chancehowarth33/OpenBand/software/firmware/README.md

# Empty application template

This is a minimal starter application template for Infineon MCU devices.

For instructions on modifying and using this application template to create applications, follow steps from the "My first PSoC&trade; 6 MCU design using ModusToolbox&trade;" section in [AN228571](https://www.infineon.com/an228571) – Getting started with PSoC&trade; 6 MCU on ModusToolbox&trade; software, the "My first TRAVEO&trade; T2G family  MCU design using Eclipse IDE for ModusToolbox&trade;" section in [AN235305](https://www.infineon.com/assets/row/public/documents/10/42/infineon-an235305-getting-started-with-traveo-t2g-family-mcus-in-modustoolbox-applicationnotes-en.pdf) – Getting started with TRAVEO&trade; T2G family MCUs in ModusToolbox&trade; software or the "My first XMC7000 MCU design using Eclipse IDE for ModusToolbox&trade;" section in [AN234334](https://www.infineon.com/dgdl/Infineon-AN234334_Getting_started_with_XMC7000_MCU_on_ModusToolbox_software-ApplicationNotes-v01_00-EN.pdf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) – Getting started with XMC7000 MCU on ModusToolbox&trade; software.

[View this README on GitHub.](https://github.com/Infineon/mtb-example-empty-app)

[Provide feedback on this code example.](https://yourvoice.infineon.com/jfe/form/SV_1NTns53sK2yiljn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)

## Requirements

- [ModusToolbox&trade;](https://www.infineon.com/modustoolbox) v3.7 or later (tested with v3.7)
- Board support package (BSP) minimum required version for :
   - PSoC&trade; 6 MCU: v4.0.0
   - KIT_XMC72_EVK: v1.0.0
   - CYW920829M2EVK-02: v1.0.1
   - CYW989829M2EVB-01: v1.0.1
   - KIT_XMC52_EVK: v3.0.0
   - KIT_T2G-B-H_EVK: v3.0.0
   - KIT_T2G-B-H_LITE: v3.0.0
   - KIT_T2G_C-2D-6M_EVK: v3.0.0
   - KIT_T2G_C-2D-4M_EVK: v3.0.0
- Programming language: C
- Associated parts: All [PSoC&trade; 6 MCU](https://www.infineon.com/cms/en/product/microcontroller/32-bit-psoc-arm-cortex-microcontroller/psoc-6-32-bit-arm-cortex-m4-mcu) parts, [XMC7000 MCU](https://www.infineon.com/products/microcontroller/32bit-industrial-arm-cortex-m/xmc7000-m7), [XMC5000 MCU](https://www.infineon.com/products/microcontroller/32bit-industrial-arm-cortex-m/xmc5000), [TRAVEO&trade; T2G family Cluster series](https://www.infineon.com/cms/en/product/microcontroller/32-bit-traveo-t2g-arm-cortex-microcontroller/32-bit-traveo-t2g-arm-cortex-for-cluster/), [TRAVEO&trade; T2G family body high CYT4BF series](https://www.infineon.com/products/microcontroller/32-bit-traveo-t2g-arm-cortex/for-body/t2g-cyt4bf) and [AIROC&trade; CYW20829/CYW89829 Bluetooth&reg; LE SoC](https://www.infineon.com/cms/en/product/wireless-connectivity/airoc-bluetooth-le-bluetooth-multiprotocol/airoc-bluetooth-le/cyw20829/)

## Supported toolchains (make variable 'TOOLCHAIN')

- GNU Arm&reg; Embedded Compiler v14.2.1 (`GCC_ARM`) - Default value of `TOOLCHAIN`
- Arm&reg; Compiler v6.22 (`ARM`)
- IAR C/C++ Compiler v9.50.2 (`IAR`)

## Supported kits (make variable 'TARGET')

- [PSoC&trade; 62S2 Wi-Fi Bluetooth&reg; Prototyping Kit](https://www.infineon.com/CY8CPROTO-062S2-43439) (`CY8CPROTO-062S2-43439`) – Default value of `TARGET`
- [AIROC&trade; CYW20829 Bluetooth&reg; LE evaluation Kit](https://www.infineon.com/CYW920829M2EVK-02) (`CYW920829M2EVK-02`)
- [PSoC&trade; 6 Wi-Fi Bluetooth&reg; Pioneer Kit](https://www.infineon.com/CY8CKIT-062-WIFI-BT) (`CY8CKIT-062-WIFI-BT`)
- [PSoC&trade; 6 Bluetooth&reg; LE Pioneer Kit](https://www.infineon.com/CY8CKIT-062-BLE) (`CY8CKIT-062-BLE`)
- [PSoC&trade; 6 Bluetooth&reg; LE Prototyping Kit](https://www.infineon.com/CY8CPROTO-063-BLE) (`CY8CPROTO-063-BLE`)
- [PSoC&trade; 62S2 Wi-Fi Bluetooth&reg; Pioneer Kit](https://www.infineon.com/CY8CKIT-062S2-43012) (`CY8CKIT-062S2-43012`)
- [PSoC&trade; 62S1 Wi-Fi Bluetooth&reg; Pioneer Kit](https://www.infineon.com/CYW9P62S1-43438EVB-01) (`CYW9P62S1-43438EVB-01`)
- [PSoC&trade; 62S1 Wi-Fi Bluetooth&reg; Pioneer Kit](https://www.infineon.com/CYW9P62S1-43012EVB-01) (`CYW9P62S1-43012EVB-01`)
- [PSoC&trade; 62S3 Wi-Fi Bluetooth&reg; Prototyping Kit](https://www.infineon.com/CY8CPROTO-062S3-4343W) (`CY8CPROTO-062S3-4343W`)
- [PSoC&trade; 6 Wi-Fi Bluetooth&reg; Prototyping Kit](https://www.infineon.com/CY8CPROTO-062-4343W) (`CY8CPROTO-062-4343W`)
- [PSoC&trade; 64 "Secure Boot" Wi-Fi Bluetooth&reg; Pioneer Kit](https://www.infineon.com/CY8CKIT-064B0S2-4343W) (`CY8CKIT-064B0S2-4343W`)
- [EZ-BLE Arduino Evaluation Board](https://www.infineon.com/cms/en/product/evaluation-boards/cyble-416045-eval/) (`CYBLE-416045-EVAL`)
- [PSoC&trade; 64 Standard Secure - AWS Wi-Fi Bluetooth&reg; Pioneer Kit](https://www.infineon.com/CY8CKIT-064S0S2-4343W) (`CY8CKIT-064S0S2-4343W`)
- [PSoC&trade; 62S4 Pioneer Kit](https://www.infineon.com/CY8CKIT-062S4) (`CY8CKIT-062S4`)
- [PSoC&trade; 62S2 Evaluation Kit](https://www.infineon.com/CY8CEVAL-062S2) (`CY8CEVAL-062S2`, `CY8CEVAL-062S2-LAI-4373M2`, `CY8CEVAL-062S2-MUR-43439M2`, `CY8CEVAL-062S2-LAI-43439M2`, `CY8CEVAL-062S2-MUR-4373EM2`, `CY8CEVAL-062S2-MUR-4373M2`, `CY8CEVAL-062S2-CYW43022CUB`, `CY8CEVAL-062S2-CYW955513SDM2WLIPA`)
- [PSoC&trade; 64 "Secure Boot" Prototyping Kit](https://www.infineon.com/CY8CPROTO-064B0S3) (`CY8CPROTO-064B0S3`)
- [PSoC&trade; 64 "Secure Boot" Prototyping Kit](https://www.infineon.com/CY8CPROTO-064S1-SB) (`CY8CPROTO-064S1-SB`)
- [XMC7200 Evaluation Kit](https://www.infineon.com/KIT_XMC72_EVK) (`KIT_XMC72_EVK`, `KIT_XMC72_EVK_MUR_43439M2`)
- AIROC&trade; CYW89829 Bluetooth&reg; LE Evaluation Board(`CYW989829M2EVB-01`)
- [XMC7100 Evaluation Kit](https://www.infineon.com/KIT_XMC71_EVK_LITE_V1) (`KIT_XMC71_EVK_LITE_V1`)
- [PSoC&trade; 6 AI Evaluation Kit](https://www.infineon.com/CY8CKIT-062S2-AI) (`CY8CKIT-062S2-AI`)
- [Traveo&trade; T2G Cluster 6M Evaluation Kit](https://www.infineon.com/cms/en/product/evaluation-boards/kit_t2g_c-2d-6m_lite/) (`KIT_T2G_C-2D-6M_LITE`)
- [XMC5200 Evaluation Kit](https://www.infineon.com/evaluation-board/KIT-XMC52-EVK) (`KIT_XMC52_EVK`)
- [TRAVEO&trade; T2G Cluster 6M Lite Kit](https://www.infineon.com/cms/en/product/evaluation-boards/kit_t2g_c-2d-6m_lite/) (`KIT_T2G_C-2D-6M_LITE`)
- [TRAVEO&trade; T2G Cluster 4M Lite Kit](https://www.infineon.com/cms/en/product/evaluation-boards/kit_t2g_c-2d-4m_lite/) (`KIT_T2G_C-2D-4M_LITE`)
- [TRAVEO&trade; T2G Body high Lite Kit](https://www.infineon.com/evaluation-board/KIT-T2G-B-H-LITE) (`KIT_T2G-B-H_LITE`)
- [TRAVEO&trade; T2G Body high Evaluation Kit](https://www.infineon.com/evaluation-board/KIT-T2G-B-H-EVK) (`KIT_T2G-B-H_EVK`)

## Hardware setup

This example uses the kit’s default configuration. See the respective kit guide to ensure that the kit is configured correctly.

**Note:** The AIROC&trade; CYW20829 Bluetooth&reg; kit (CYW920829M2EVK-02) ships with KitProg3 version 2.21 installed. The ModusToolbox&trade; software requires KitProg3 with latest version 2.40. Before using this code example, make sure that the board is upgraded to KitProg3. The tool and instructions are available in the [Firmware Loader](https://github.com/Infineon/Firmware-loader) GitHub repository. If you do not upgrade, you will see an error such as "unable to find CMSIS-DAP device" or "KitProg firmware is out of date".

## VSCode Setup

### Prerequisites

1. Install **ModusToolbox v3.7+** from Infineon — the build system expects it at `/Applications/ModusToolbox/tools_*` on macOS.
2. Install the following VSCode extensions:
   - **clangd** — IntelliSense (already configured via `.clangd` in the project)
   - **Cortex-Debug** — flashing and debugging on the PSoC6
   - **ModusToolbox** (optional) — Infineon's official extension

### First-time setup

Open a terminal in this directory (`software/firmware/`) and run:

```bash
make getlibs
```

This fetches the FreeRTOS and retarget-io libraries defined in `deps/`. The `libs/` folder is gitignored so it is not in the repo — this step is required before the project will build.

Then generate the VSCode config files:

```bash
make vscode
```

This creates a `.vscode/` folder (also gitignored) containing `launch.json`, `tasks.json`, and `c_cpp_properties.json` pre-configured for the PSoC6 target.

### Open in VSCode

Open **this folder** specifically — not the repo root:

```bash
code .
```

### Common make targets

| Command | Description |
|---|---|
| `make build` | Compile firmware |
| `make program` | Flash to the board via OpenOCD |
| `make clean` | Remove build artifacts |
| `make getlibs` | Fetch/update library dependencies |
| `make vscode` | Regenerate VSCode config files |

### Debug output

UART retarget-io is initialized on **P5_0 / P5_1** at **115200 baud**. Connect a serial monitor to the KitProg3 USB COM port to see debug output.

## Related resources

Resources  | Links
-----------|----------------------------------
Application notes  | [AN228571](https://www.infineon.com/AN228571) – Getting started with PSoC&trade; 6 MCU on ModusToolbox&trade; software <br>  [AN238254](https://www.infineon.com/dgdl/Infineon-AN238254_Getting_started_with_AIROC_CYW20829_Bluetooth_LE_on_ModusToolbox-ApplicationNotes-v01_00-EN.pdf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) – Getting started with AIROC&trade; CYW20829 Bluetooth&reg; LE on ModusToolbox&trade; <br>  [AN215656](https://www.infineon.com/AN215656) – PSoC&trade; 6 MCU: Dual-CPU system design <br> [AN234334](https://www.infineon.com/AN234334) – Getting started with XMC&trade; 7000 MCU on ModusToolbox&trade; software <br> [AN241720](https://www.infineon.com/document-promo/infineon-an241720-getting-started-with-xmc5000-mcu-on-modustoolbox-software_1071f992-eb73-4dce-94ad-e84c41407bfc) – Getting started with XMC5000 MCU on ModusToolbox&trade; software <br>  [AN235305](https://www.infineon.com/assets/row/public/documents/10/42/infineon-an235305-getting-started-with-traveo-t2g-family-mcus-in-modustoolbox-applicationnotes-en.pdf) – Getting started with TRAVEO™ T2G family MCUs in ModusToolbox&trade;
Code examples  | [Using ModusToolbox&trade;](https://github.com/Infineon/Code-Examples-for-ModusToolbox-Software) on GitHub <br> [Using PSoC&trade; Creator](https://www.infineon.com/cms/en/design-support/software/code-examples/psoc-3-4-5-code-examples-for-psoc-creator/)
Device documentation | [PSoC&trade; 6 MCU datasheets](https://www.infineon.com/cms/en/search.html#!view=downloads&term=psoc6&doc_group=Data%20Sheet) <br> [PSoC&trade; 6 technical reference manuals](https://www.infineon.com/cms/en/search.html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) <br> [AIROC&trade; CYW20829 Bluetooth&reg; LE SoC](https://www.infineon.com/dgdl/Infineon-CYW20829_AIROC_TM_Bluetooth_R_LE_5_4_MCU-DataSheet-v07_00-EN.pdf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) <br> [XMC5000 MCUs documents](https://www.infineon.com/products/microcontroller/32bit-industrial-arm-cortex-m/xmc5000#Documents) <br>[TRAVEO&trade; T2G body high family MCUs datasheets](https://www.infineon.com/products/microcontroller/32-bit-traveo-t2g-arm-cortex/for-body/t2g-cyt4bf/#documents) <br> [TRAVEO&trade; T2G body high family MCUs architecture/registers reference manuals](https://www.infineon.com/products/microcontroller/32-bit-traveo-t2g-arm-cortex/for-body/t2g-cyt4bf/#documents) <br> [TRAVEO&trade; T2G cluster family MCUs datasheets for CYT4DN](https://www.infineon.com/products/microcontroller/32-bit-traveo-t2g-arm-cortex/for-cluster/#documents) <br> [TRAVEO&trade; T2G cluster family MCUs architecture/registers reference manuals for CYT4DN](https://www.infineon.com/products/microcontroller/32-bit-traveo-t2g-arm-cortex/for-cluster/#documents) <br> [TRAVEO&trade; T2G cluster family MCUs datasheets for CYT3DL](https://www.infineon.com/products/microcontroller/32-bit-traveo-t2g-arm-cortex/for-cluster/#documents) <br> [TRAVEO&trade; T2G cluster family MCUs architecture/registers reference manuals for CYT3DL](https://www.infineon.com/products/microcontroller/32-bit-traveo-t2g-arm-cortex/for-cluster/#documents)
Development kits | Select your kits from the [Evaluation board finder](https://www.infineon.com/cms/en/design-support/finder-selection-tools/product-finder/evaluation-board) page
Libraries on GitHub  | [mtb-pdl-cat1](https://github.com/Infineon/mtb-pdl-cat1) – PSoC&trade; 6 Peripheral Driver Library (PDL)  <br> [mtb-hal-cat1](https://github.com/Infineon/mtb-hal-cat1) – Hardware Abstraction Layer (HAL) library <br> [retarget-io](https://github.com/Infineon/retarget-io) – Utility library to retarget STDIO messages to a UART port
Middleware on GitHub  | [capsense](https://github.com/Infineon/capsense) – CAPSENSE&trade; library and documents <br> [psoc6-middleware](https://github.com/Infineon/modustoolbox-software#psoc-6-middleware-libraries) – Links to all PSoC&trade; 6 MCU middleware
Tools  | [ModusToolbox&trade;](https://www.infineon.com/modustoolbox) – ModusToolbox&trade; software is a collection of easy-to-use libraries and tools enabling rapid development with Infineon MCUs for applications ranging from wireless and cloud-connected systems, edge AI/ML, embedded sense and control, to wired USB connectivity using PSoC&trade; Industrial/IoT MCUs, AIROC&trade; Wi-Fi and Bluetooth&reg; connectivity devices, XMC&trade; Industrial MCUs, and EZ-USB&trade;/EZ-PD&trade; wired connectivity controllers. ModusToolbox&trade; incorporates a comprehensive set of BSPs, HAL, libraries, configuration tools, and provides support for industry-standard IDEs to fast-track your embedded application development.

<br>

## Other resources

Infineon provides a wealth of data at www.infineon.com to help you select the right device, and quickly and effectively integrate it into your design.

For PSoC&trade; 6 MCU devices, see [How to design with PSoC&trade; 6 MCU - KBA223067](https://community.infineon.com/docs/DOC-14644) in the Infineon Developer community.

## Document history

Document title: *CE228742* – *Empty application template*

 Version | Description of change
 ------- | ---------------------
 1.0.0   | New code example
 1.1.0   | Updated to support ModusToolbox&trade; software v2.1, added new kits
 2.0.0   | Major update to support ModusToolbox&trade; software v2.2, added support for new kits<br> This version is not backward compatible with ModusToolbox&trade; software v2.1
 2.1.0   | Added support for new kits
 3.0.0   | Updated to BSP v3.X and added support for new kits 
 4.0.0   | Major update to support ModusToolbox&trade; software v3.0 <br> Added support for KIT_XMC72_EVK, CY8CKIT-064S0S2-4343W and CYW920829M2EVB-01
 4.1.0   | Added support for CY8CPROTO-064B0S3 CY8CPROTO-064S1-SB
 4.2.0   | Added support for CY8CEVAL-062S2-LAI-43439M2
 4.3.0   | Removed CYW920829M2EVB-01 from supported ktis <br> Added support for CY8CPROTO-062S2-43439, CYBLE-416045-EVAL and CYW920829M2EVK-02
 4.4.0   | Added support for CY8CEVAL-062S2-MUR-4373EM2, CY8CEVAL-062S2-MUR-4373M2
 4.4.1   | Readme Update
 4.5.0   | Added support for CYW989829M2EVB-01 and updated to support ModusToolbox&trade; v3.1
 4.6.0   | Added support for KIT_XMC72_EVK_MUR_43439M2 and KIT_XMC71_EVK_LITE_V1.
 4.7.0   | Added support for CY8CEVAL-062S2-CYW43022CUB
 4.8.0   | Added support for CY8CKIT-062S2-AI
 4.9.0   | Added support for CY8CEVAL-062S2-CYW955513SDM2WLIPA
 4.9.1   | Added support for devices not supported by HAL, added support for KIT_T2G_C-2D-6M_LITE
 4.9.2   | Added support for KIT_XMC52_EVK, KIT_T2G-B-H_EVK, KIT_T2G-B-H_LITE and KIT_T2G_C-2D-4M_LITE
 <br>

All referenced product or service names and trademarks are the property of their respective owners.

The Bluetooth® word mark and logos are registered trademarks owned by Bluetooth SIG, Inc., and any use of such marks by Infineon is under license.

PSOC™, formerly known as PSoC™, is a trademark of Infineon Technologies. Any references to PSoC™ in this document or others shall be deemed to refer to PSOC™.

---------------------------------------------------------
(c) 2021-2026, Infineon Technologies AG, or an affiliate of Infineon Technologies AG. All rights reserved.
This software, associated documentation and materials ("Software") is owned by Infineon Technologies AG or one of its affiliates ("Infineon") and is protected by and subject to worldwide patent protection, worldwide copyright laws, and international treaty provisions. Therefore, you may use this Software only as provided in the license agreement accompanying the software package from which you obtained this Software. If no license agreement applies, then any use, reproduction, modification, translation, or compilation of this Software is prohibited without the express written permission of Infineon.
<br>
Disclaimer: UNLESS OTHERWISE EXPRESSLY AGREED WITH INFINEON, THIS SOFTWARE IS PROVIDED AS-IS, WITH NO WARRANTY OF ANY KIND, EXPRESS OR IMPLIED, INCLUDING, BUT NOT LIMITED TO, ALL WARRANTIES OF NON-INFRINGEMENT OF THIRD-PARTY RIGHTS AND IMPLIED WARRANTIES SUCH AS WARRANTIES OF FITNESS FOR A SPECIFIC USE/PURPOSE OR MERCHANTABILITY. Infineon reserves the right to make changes to the Software without notice. You are responsible for properly designing, programming, and testing the functionality and safety of your intended application of the Software, as well as complying with any legal requirements related to its use. Infineon does not guarantee that the Software will be free from intrusion, data theft or loss, or other breaches (“Security Breaches”), and Infineon shall have no liability arising out of any Security Breaches. Unless otherwise explicitly approved by Infineon, the Software may not be used in any application where a failure of the Product or any consequences of the use thereof can reasonably be expected to result in personal injury.
