chancehowarth33/OpenBand/case/case_band_example.png

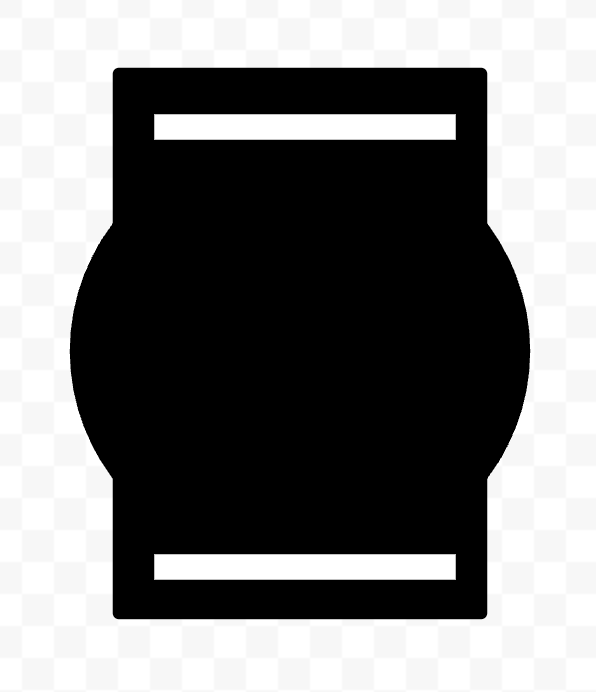
case/case_band_example.png
