chancehowarth33/OpenBand/devices/peripheral/LDO1_TA.png

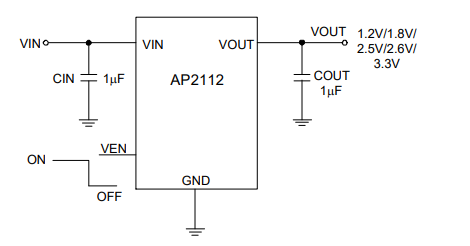
devices/peripheral/LDO1_TA.png
