chancehowarth33/OpenBand/devices/peripheral/LDO2_TA.png

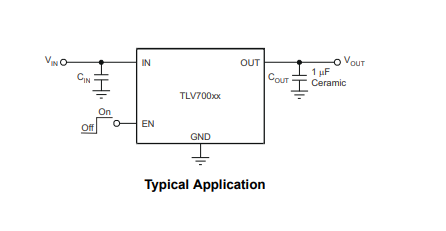
devices/peripheral/LDO2_TA.png
