chancehowarth33/OpenBand/devices/peripheral/Psoc_breakout_pinout.png

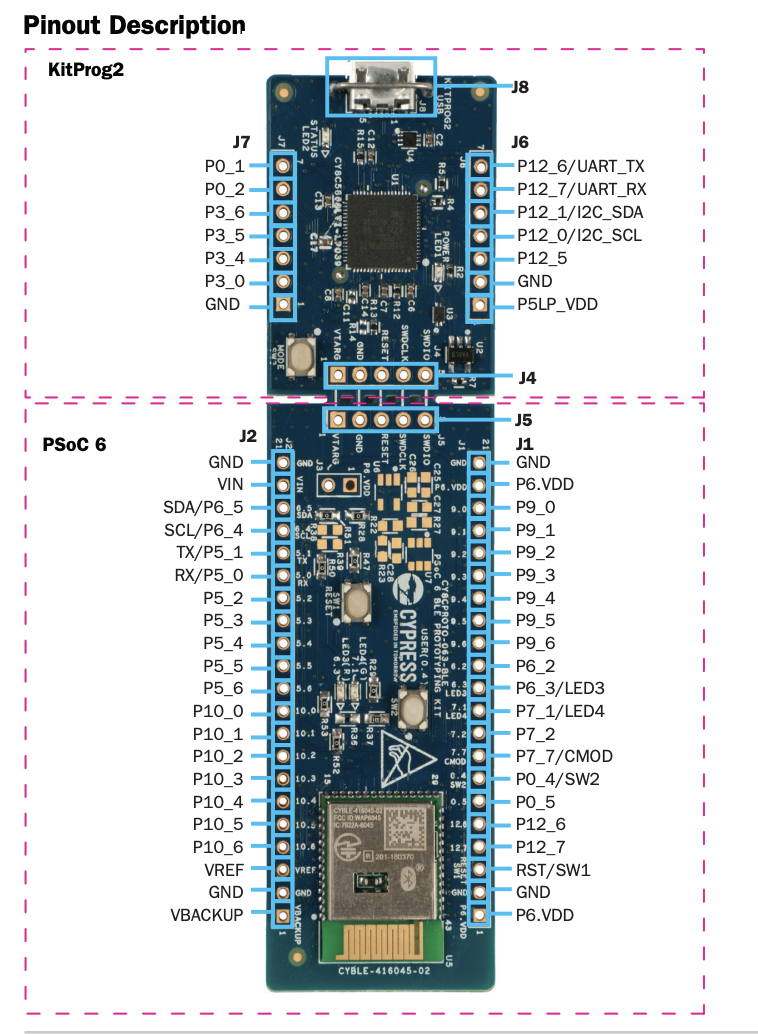
devices/peripheral/Psoc_breakout_pinout.png
