chancehowarth33/OpenBand/devices/peripheral/shared_I2C_values.png

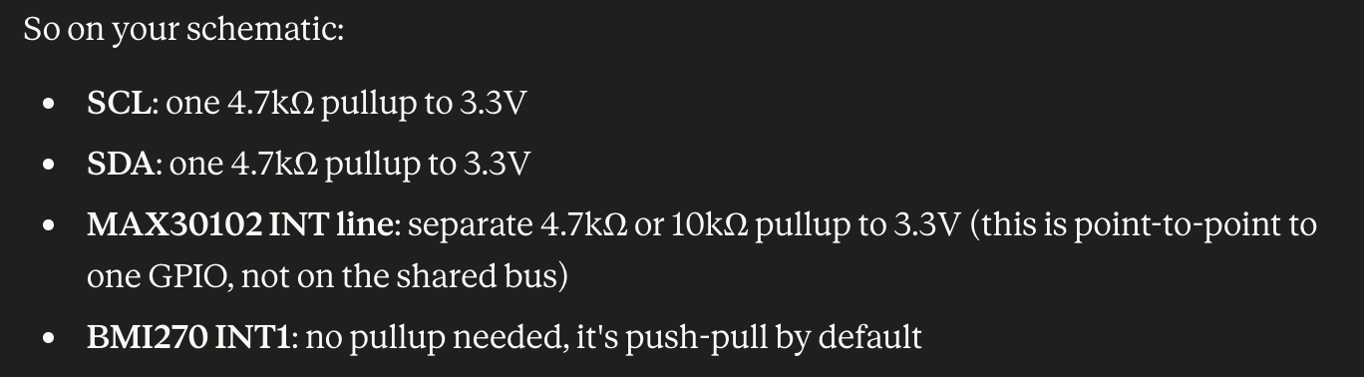
devices/peripheral/shared_I2C_values.png
