chancehowarth33/OpenBand/devices/peripheral/typical_application_MAX30102.png

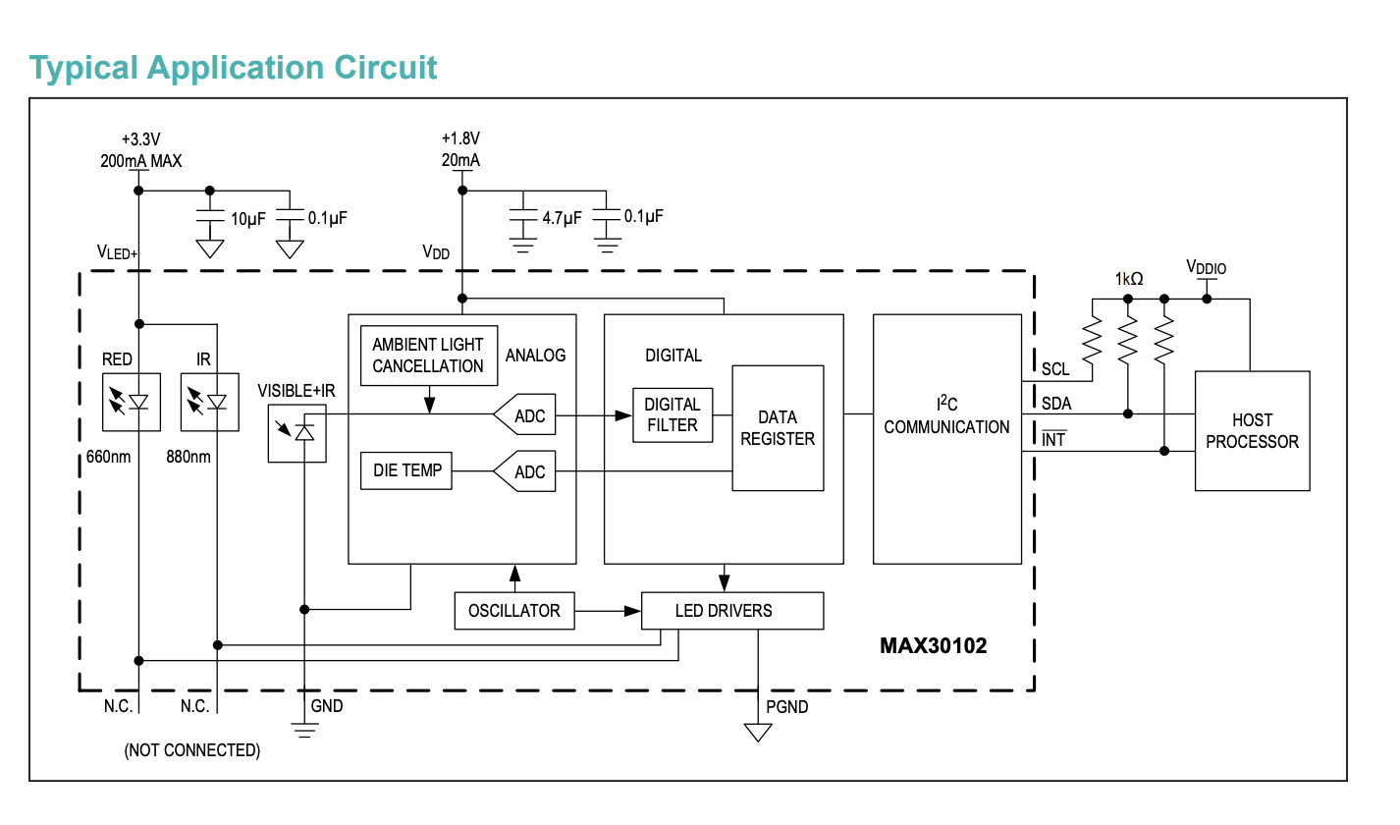
devices/peripheral/typical_application_MAX30102.png
