chancehowarth33/OpenBand/devices/peripheral/typical_application_MCP.png

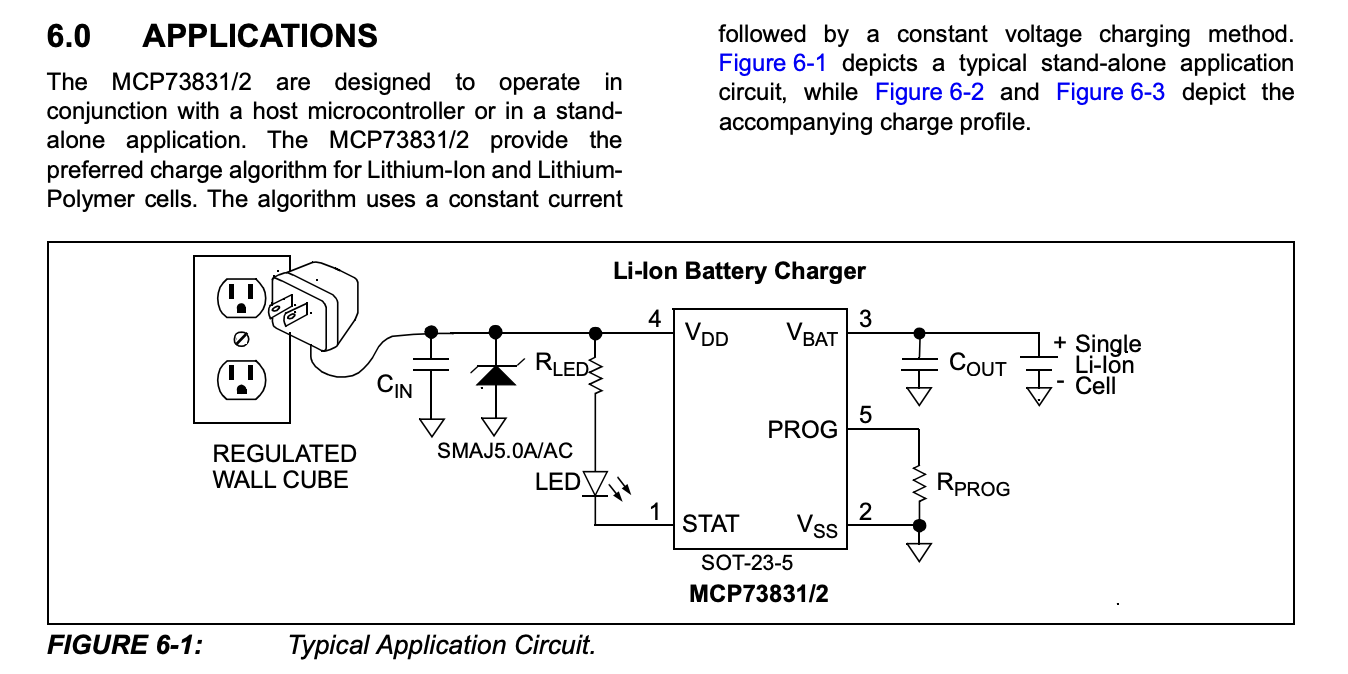
devices/peripheral/typical_application_MCP.png
