chancehowarth33/OpenBand/devices/SoC/circuit_config.png

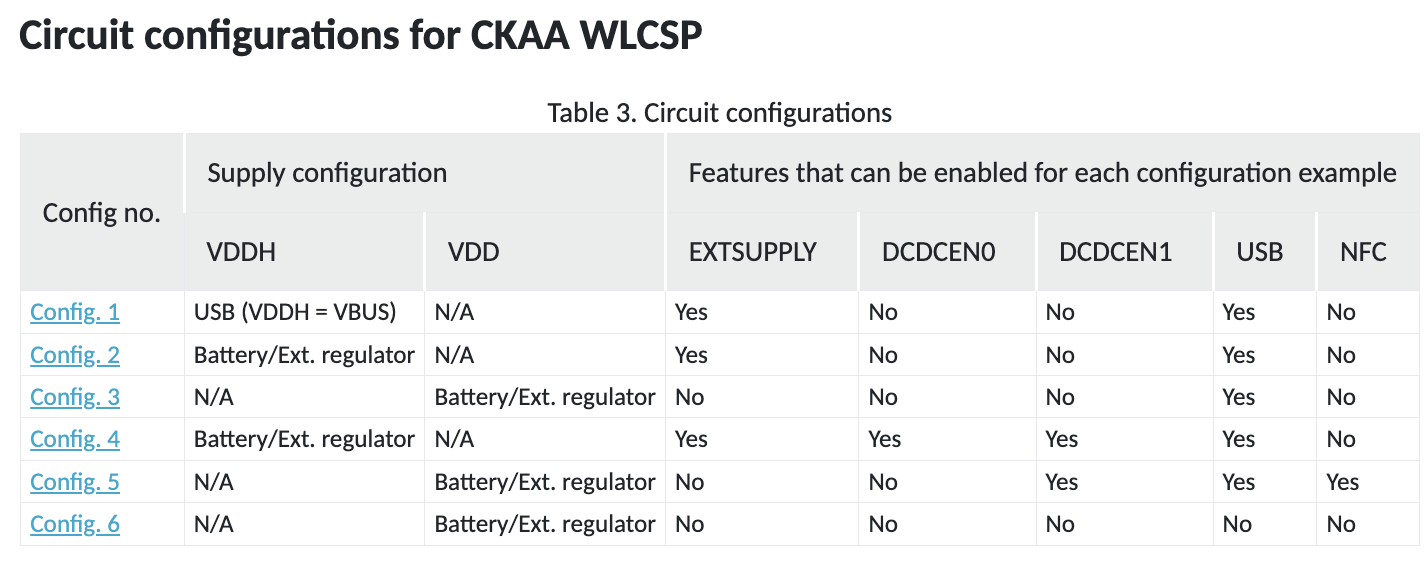
devices/SoC/circuit_config.png
