chancehowarth33/OpenBand/devices/SoC/nRF52840-CKAA Reference Layout Config 4/Bill of Materials/nrf52840_ckaa_config4_bom.xls

Bill of material
Device: | nRF52840-CKAA
Title: | Reference Layout Config. 4: VDDH supply, DCDC, USB
Version: | 1.2
Designator | Value | Description | Assembly | Footprint Doc
C1, C2, C17, C18 | 12pF | Capacitor, NP0, ±2% |  | 0201
C3 | 1.0pF | Capacitor, NP0, ±5% |  | 0201
C5, C7, C8, C12 | 100nF | Capacitor, X7R, ±10% |  | 0201
C6, C20 | 4.7µF | Capacitor, X7R, ±10% |  | 0603
C9 | 820pF | Capacitor, X7R, ±10% | Not required for Fxx and later | 0201
C14, C15 | 1.0µF | Capacitor, X7R, ±10% |  | 0603
C16 | 47nF | Capacitor, X7R, ±10% |  | 0201
C19, C21 | 4.7µF | Capacitor, X7S, ±10% |  | 0603
L1 | 3.9nH | High frequency chip inductor ±5% |  | 0201
L2 | 10µH | Chip inductor, IDC,min = 50 mA, ±20% |  | 0603
L3 | 15nH | High frequency chip inductor ±10% |  | 0402
L4 | 10µH | Chip inductor, IDC,min = 80 mA, ±10% |  | 0603
L5 | 4.7nH | High frequency chip inductor ±5% |  | 0201
U1 | nRF52840-CKAA | Multi-protocol Bluetooth Low Energy, IEEE 802.15.4, ANT and 2.4GHz proprietary system-on-chip |  | WLCSP-94
X1 | 32MHz | XTAL SMD 2016, 32MHz, Cl=8pF, Total Tol: ±40ppm |  | XTAL_2016
X2 | 32.768kHz | XTAL SMD 2012, 32.768kHz, Cl=9pF, Total Tol: ±50ppm |  | XTAL_2012
