chancehowarth33/OpenBand/case/openband_case_V2.stl

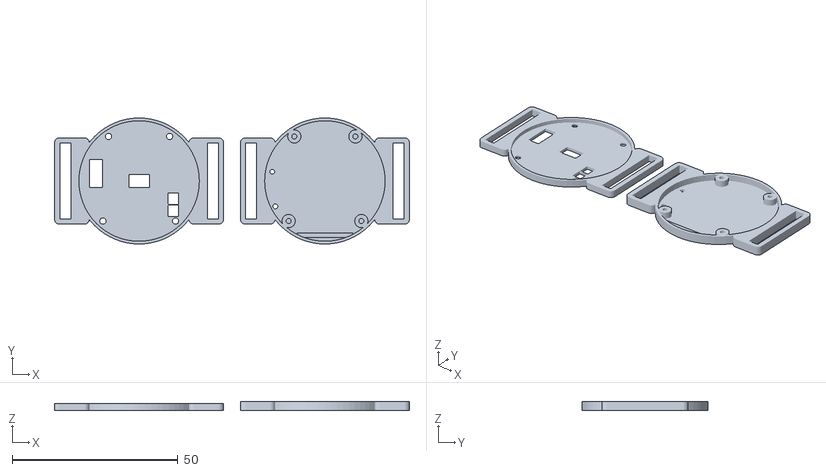
[picture p26: CAD file, 2026-06-29]
case/openband_case_V2.stl
107.0 x 38.0 x 2.80
