chancehowarth33/OpenBand/pcb/altium_project/3D/BU2032SM-HD-GCR2032 Battery Holder.stp

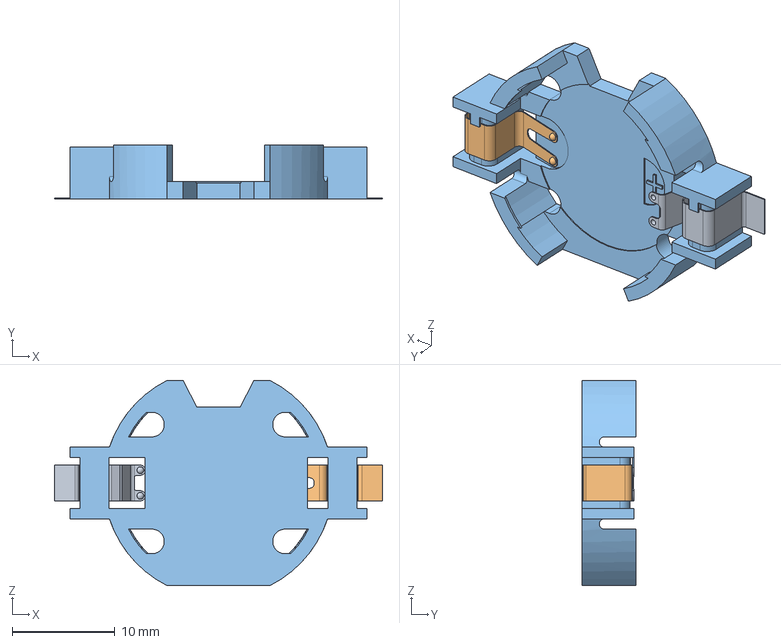
[picture p27: CAD file, 2026-04-27]
pcb/altium_project/3D/BU2032SM-HD-GCR2032 Battery Holder.stp
32.0 x 5.30 x 20.0 mm
