chancehowarth33/OpenBand/pcb/altium_project/3D/STEP-61301021821-rev1.stp

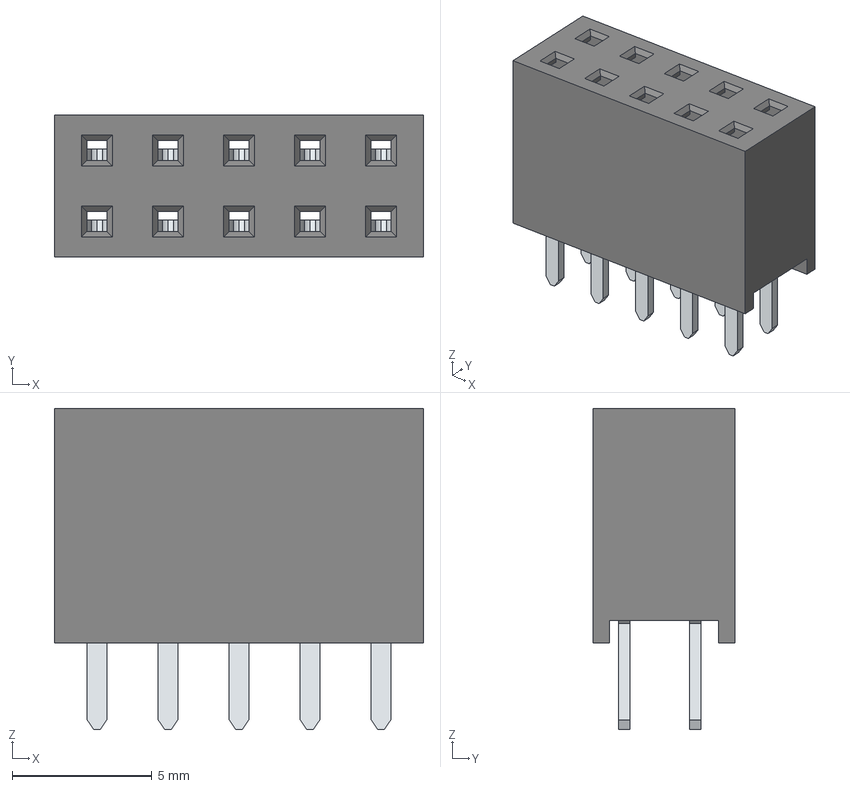
[picture p28: CAD file, 2026-04-27]
pcb/altium_project/3D/STEP-61301021821-rev1.stp
13.2 x 5.08 x 11.5 mm
6130xx21821_PIN x 10
