chancehowarth33/OpenBand/case/openband_case.3mf

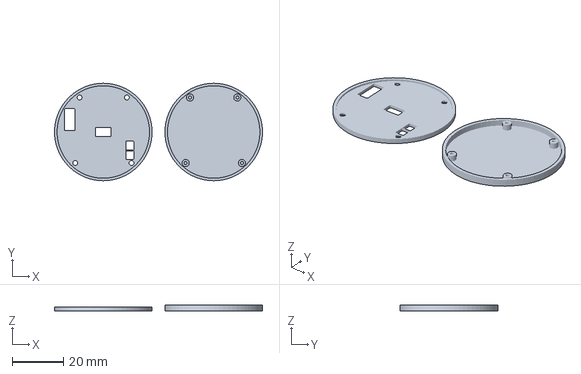
[picture p29: CAD file, 2026-06-23]
case/openband_case.3mf
81.0 x 38.0 x 2.30 mm
