chancehowarth33/OpenBand/pcb/altium_project/3D/APA102C.STEP

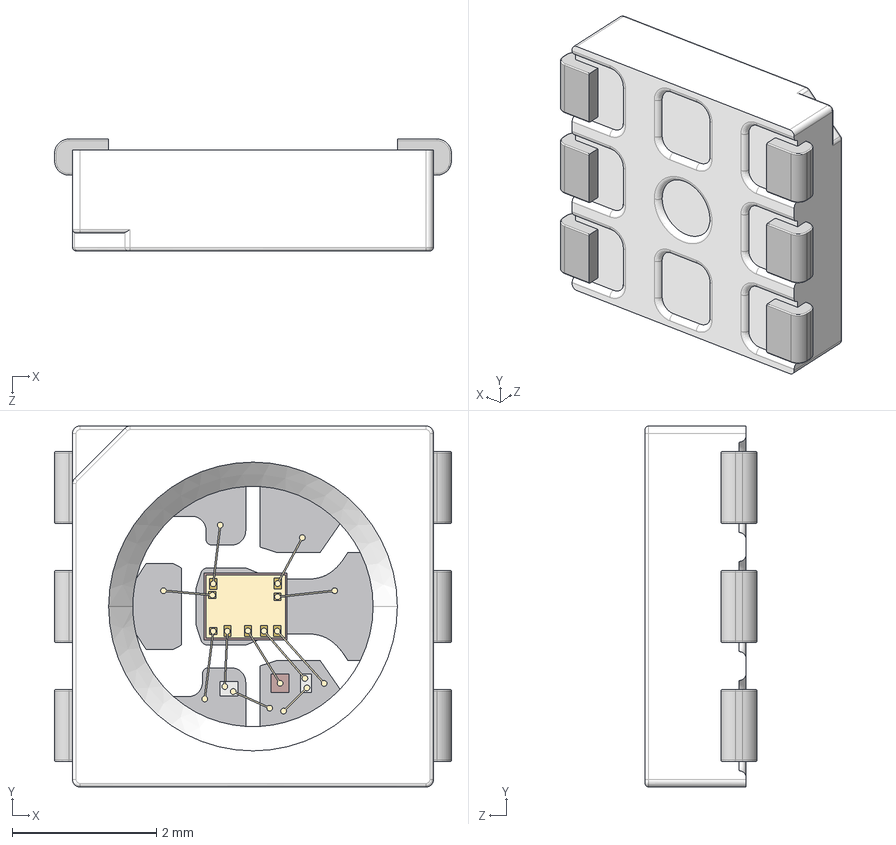
[picture p30: CAD file, 2026-04-27]
pcb/altium_project/3D/APA102C.STEP
5.50 x 5.00 x 1.55 mm
