chancehowarth33/OpenBand/(list of files, cad)

Other CAD files:
case/watchwise_case_strap.stl
case/openband_case_strap.stl
case/watchwise_case_V2.scad
case/openband_case_V1.scad
case/watchwise_case_V1.scad
