chancehowarth33/OpenBand/images/assembled_back.jpeg

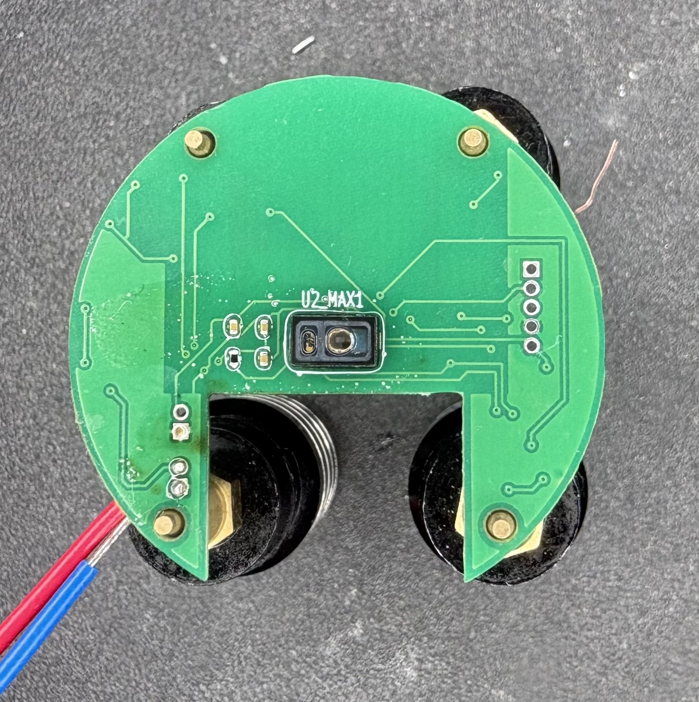
images/assembled_back.jpeg
