chancehowarth33/OpenBand/images/assembled_front.jpeg

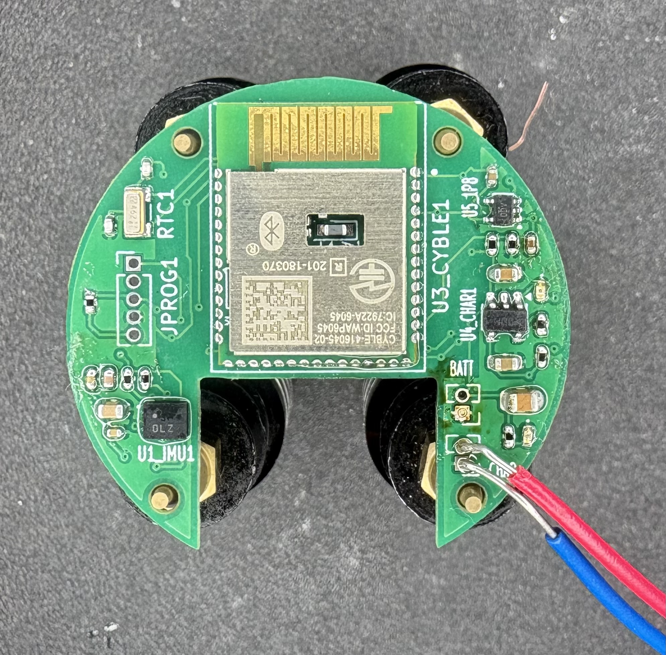
images/assembled_front.jpeg
