chancehowarth33/OpenBand/devices/SoC/nRF52840-CKAA Reference Layout Config 4/Schematic and Layout pdf files/nrf52840_ckaa_config4_pcb.pdf

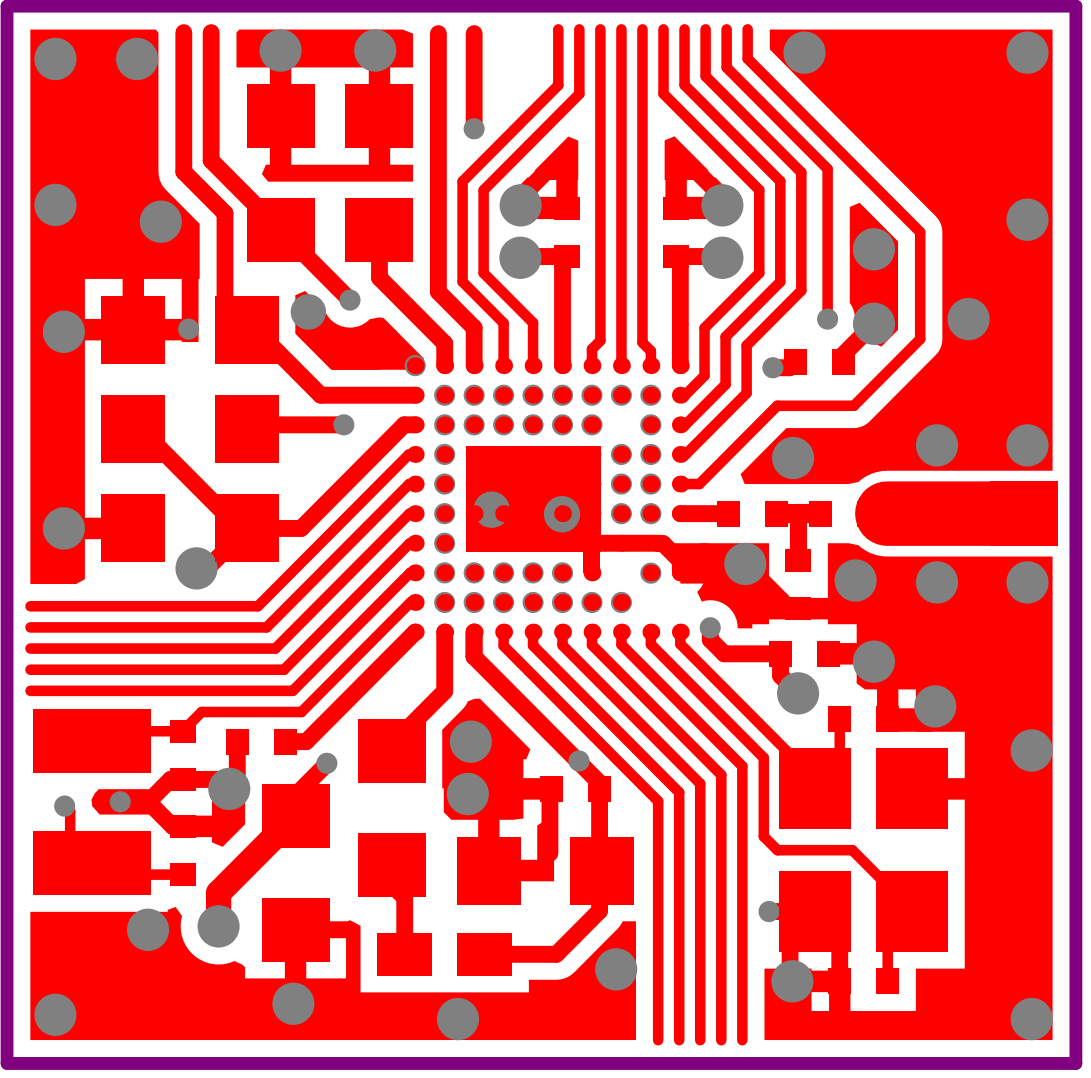
[picture p33: page 1]

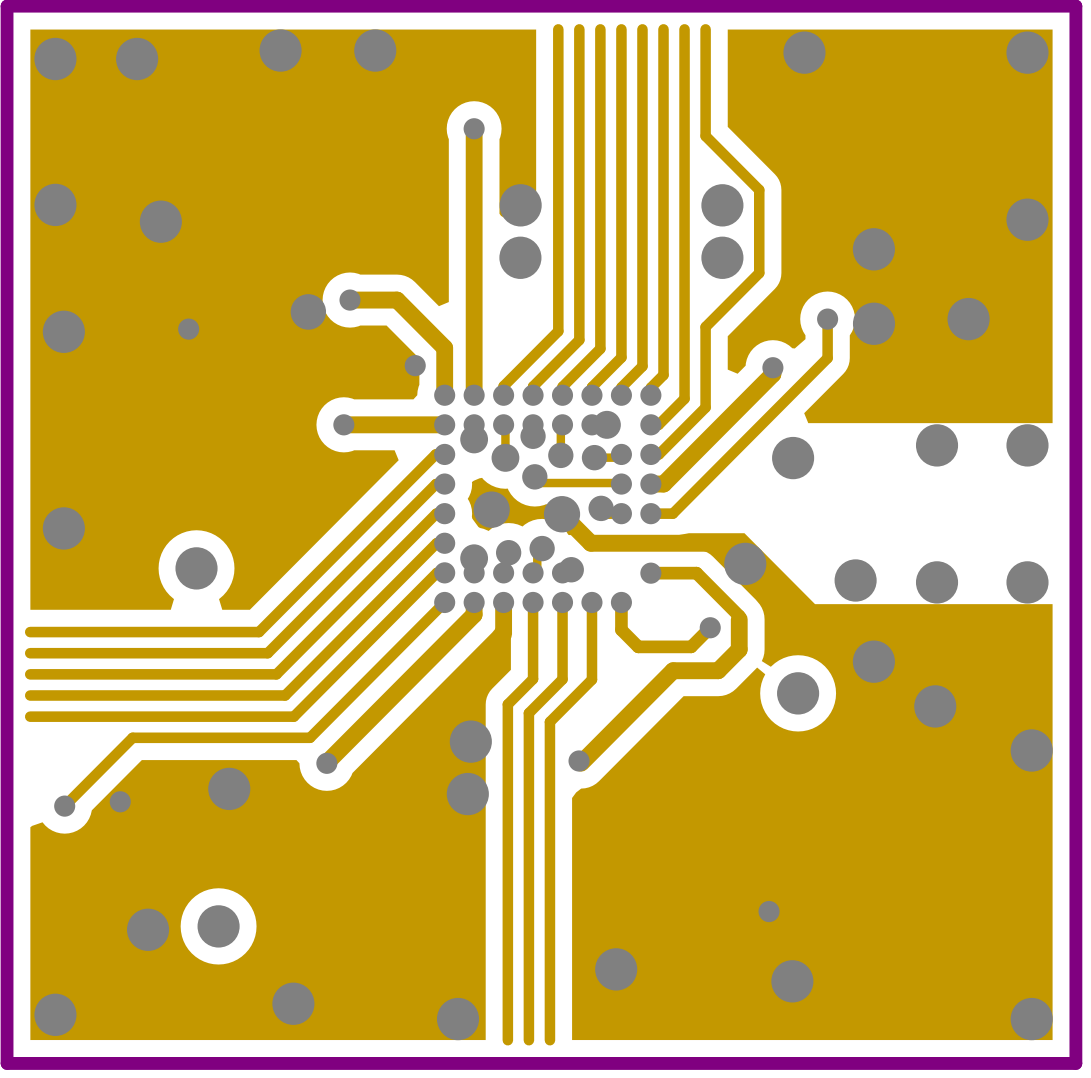
[picture p34: page 2]

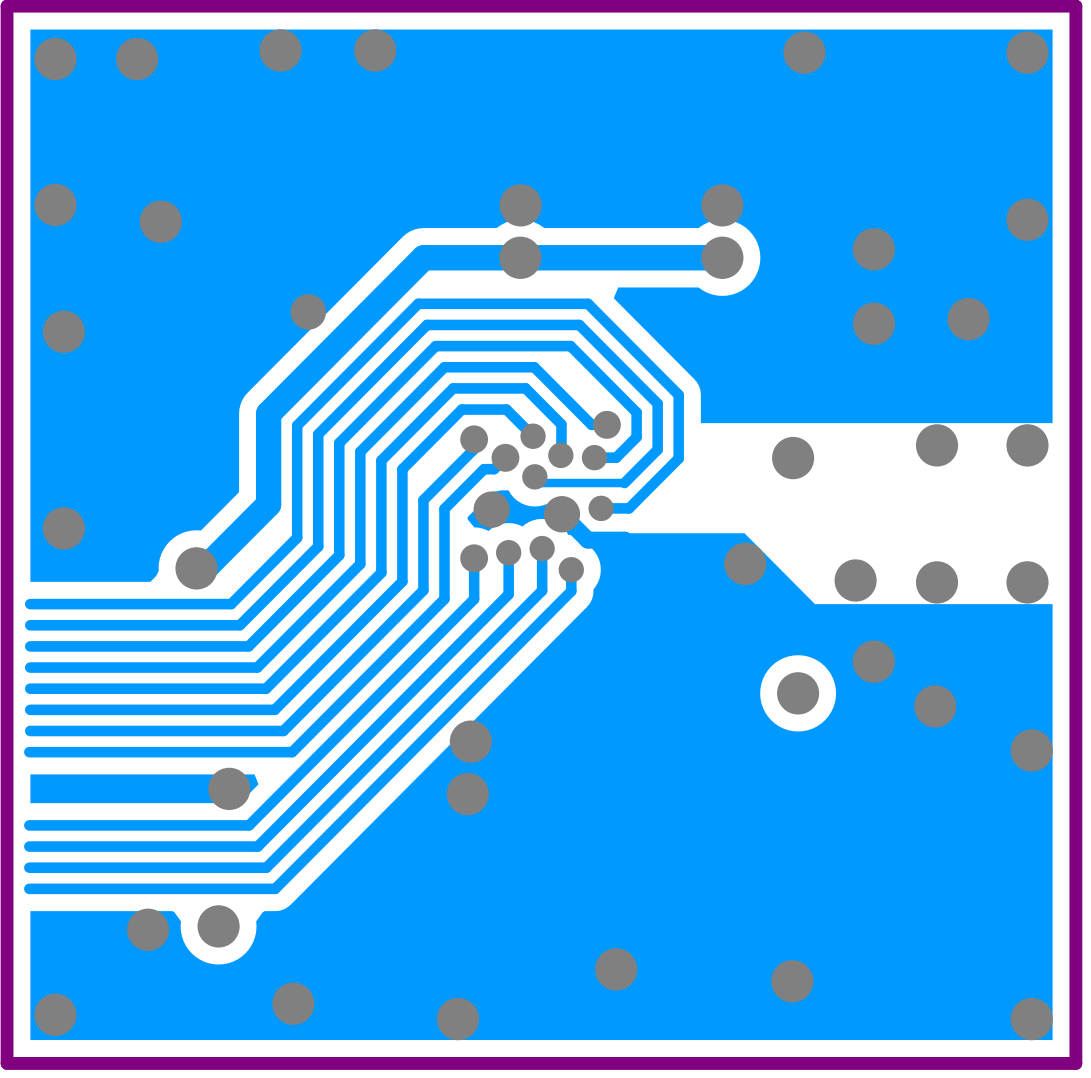
[picture p35: page 3]

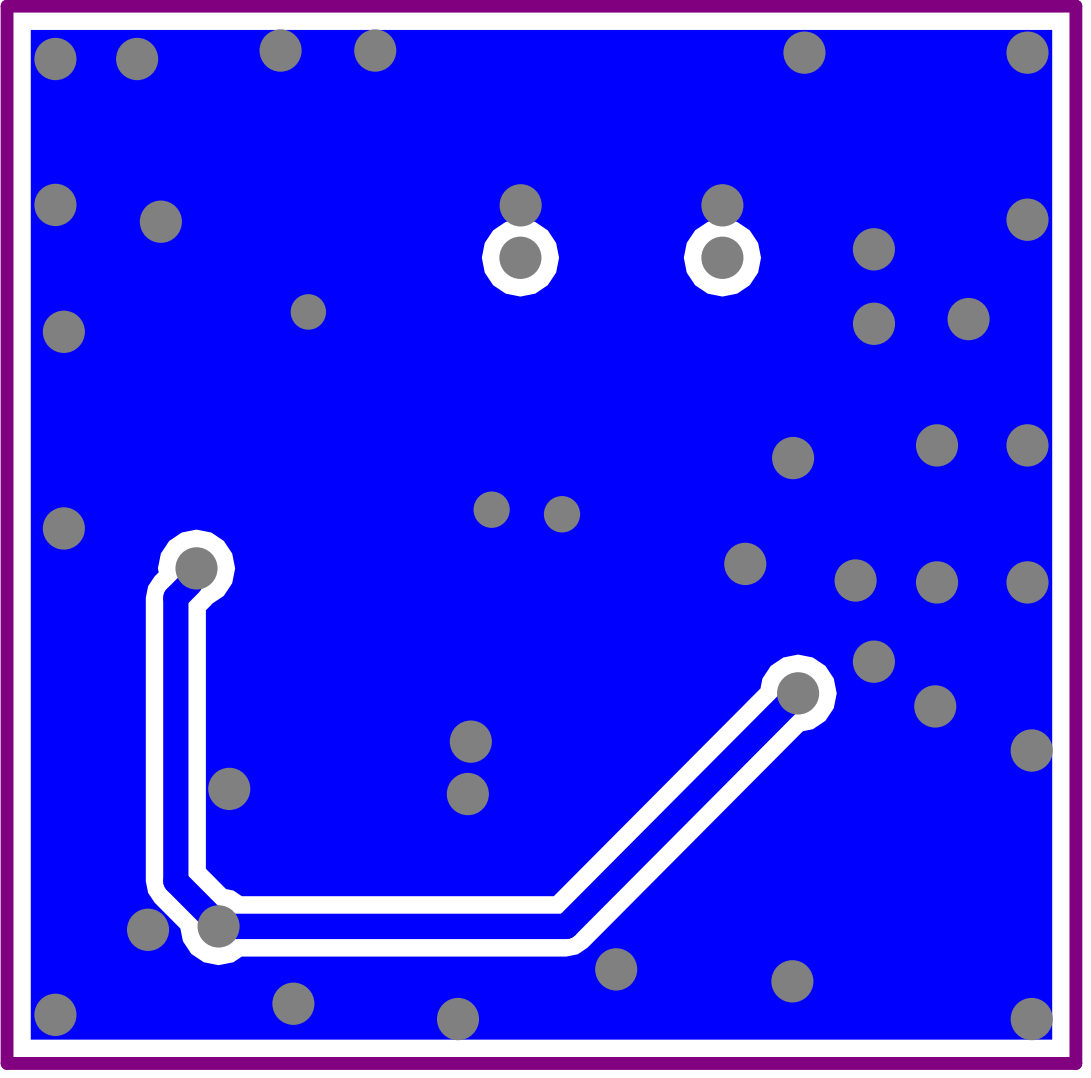
[picture p36: page 4]

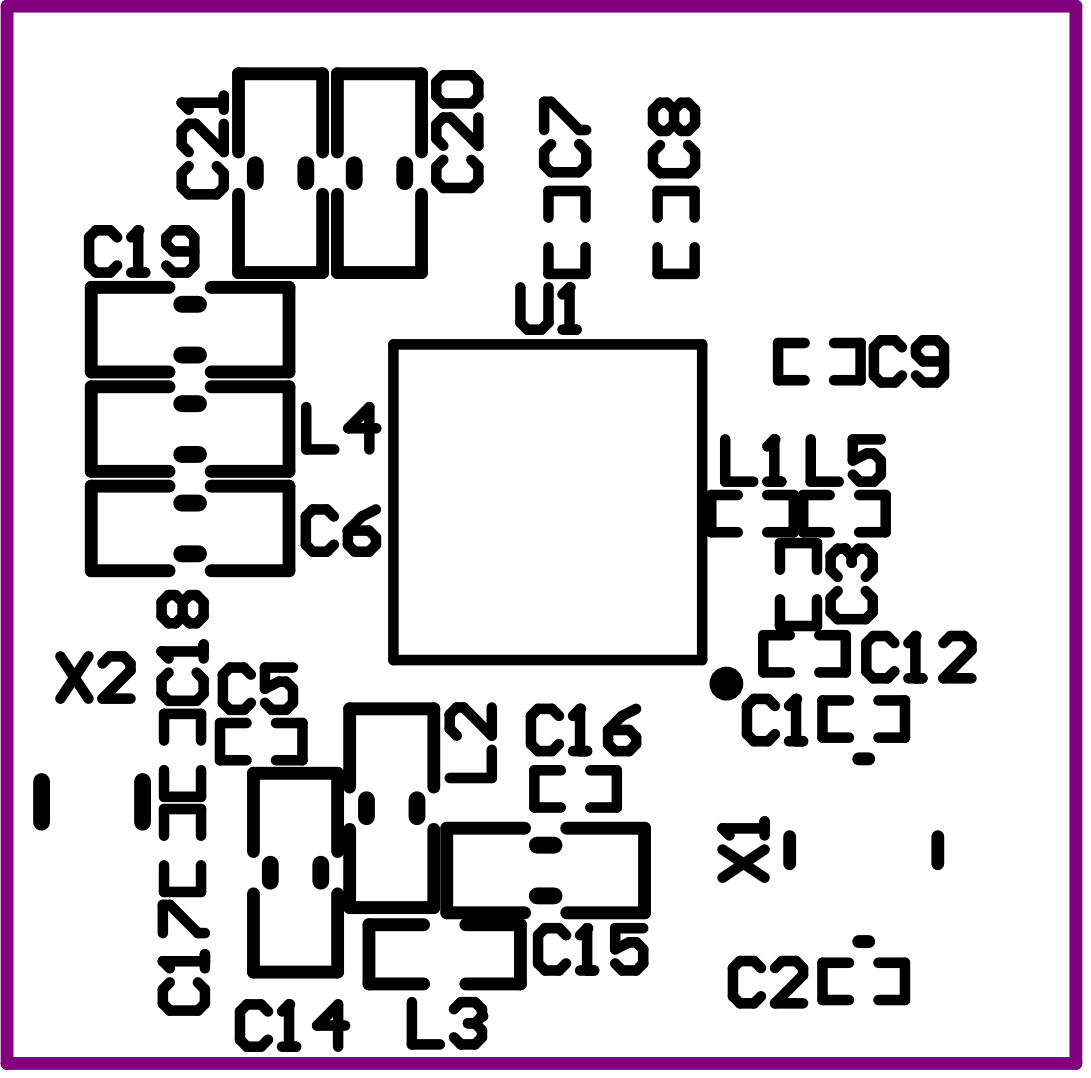
[picture p37: page 5]
