chancehowarth33/OpenBand/devices/SoC/nRF52840-CKAA Reference Layout Config 4/Schematic and Layout pdf files/nrf52840_ckaa_config4_schematic.pdf

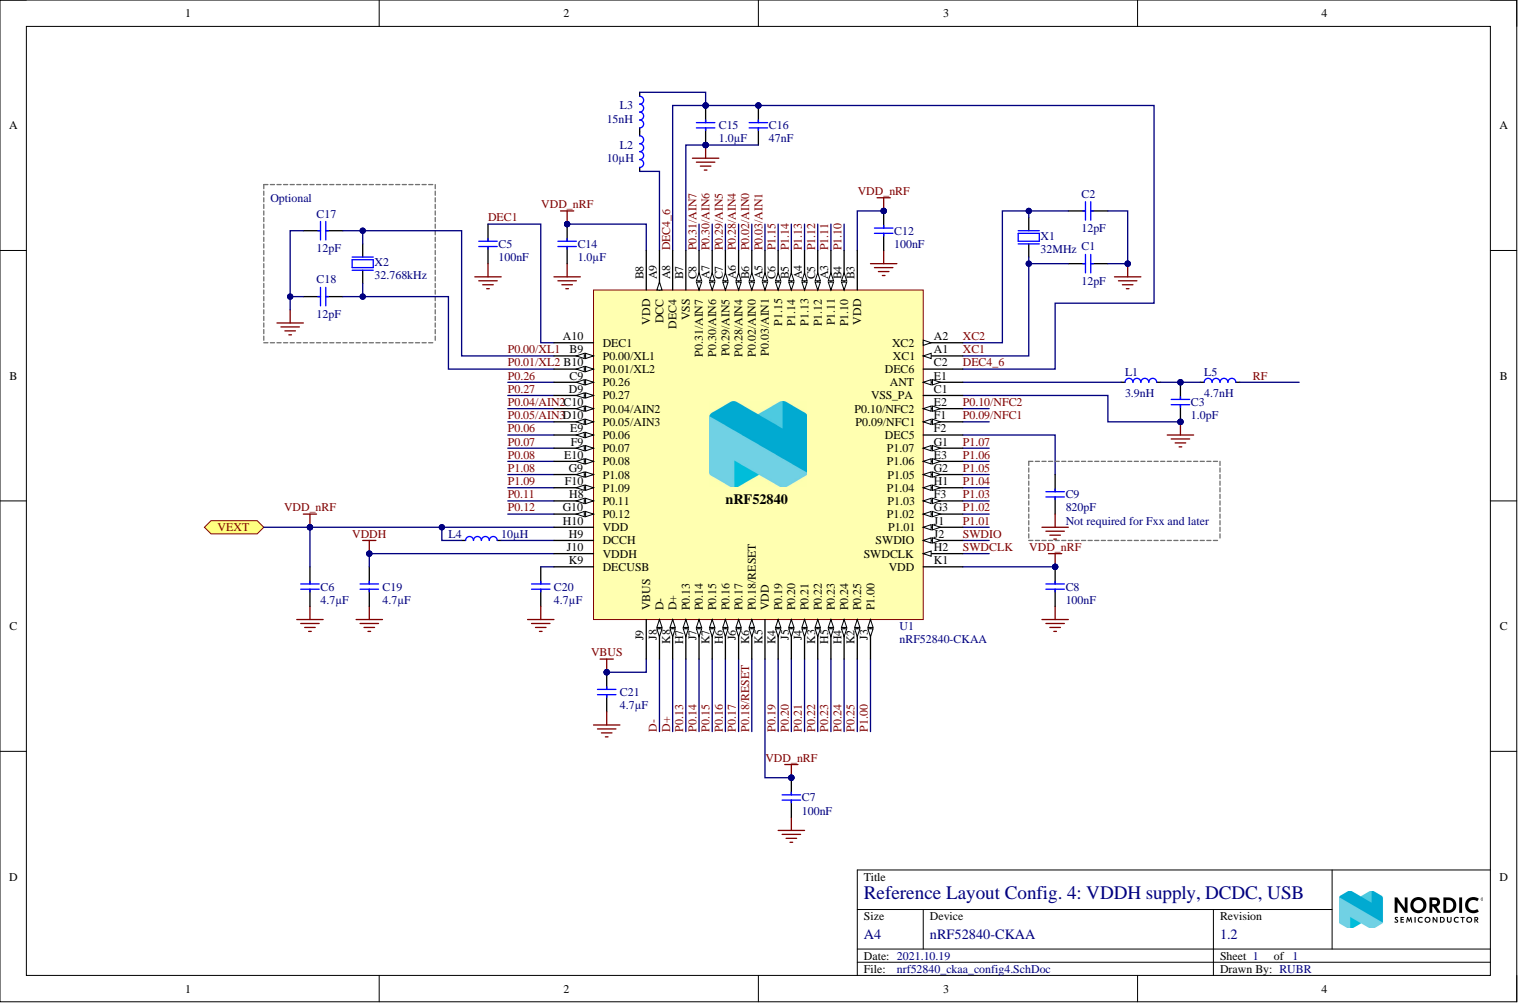
[picture p38: page 1]

Not required for Fxx and later

Title
Reference Layout Config. 4: VDDH supply, DCDC, USB
