chancehowarth33/OpenBand/(list of files, drawings)

Other design files:
devices/SoC/nRF52840-CKAA Reference Layout Config 4/Altium Designer files/nrf52840_ckaa_config4.PcbDoc
devices/SoC/nRF52840-CKAA Reference Layout Config 4/Altium Designer files/nrf52840_ckaa_config4.PrjPCB
devices/SoC/nRF52840-CKAA Reference Layout Config 4/Altium Designer files/nrf52840_ckaa_config4.SchDoc
pcb/altium_project/01-Revision_History_and_Contents.SchDoc
pcb/altium_project/02-Components.SchDoc
pcb/altium_project/03-MCU.SchDoc
pcb/altium_project/04-Programming_Reset.SchDoc
pcb/altium_project/ECE453.PcbDoc
pcb/altium_project/uw-altium-parts/uw-madison-parts.PcbLib
pcb/altium_project/uw-altium-parts/uw-madison-parts.SchLib
pcb/altium_project/watchwise_main.PrjPcb
