chancehowarth33/OpenBand/pcb/watchwise_main_kicad/watchwise_main.kicad_pcb

## KiCad design pcb/watchwise_main_kicad/watchwise_main.kicad_pcb (2026-05-15)

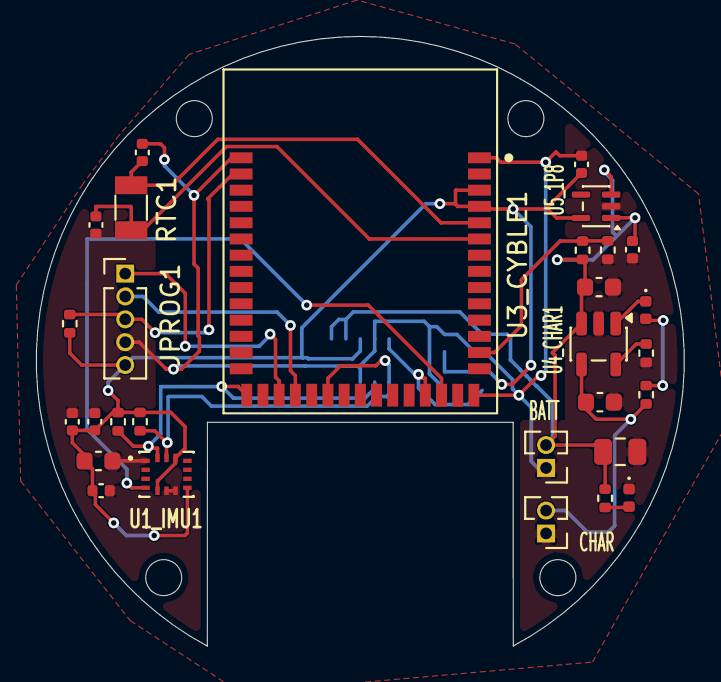
[picture p39: board watchwise_main.kicad_pcb from above]

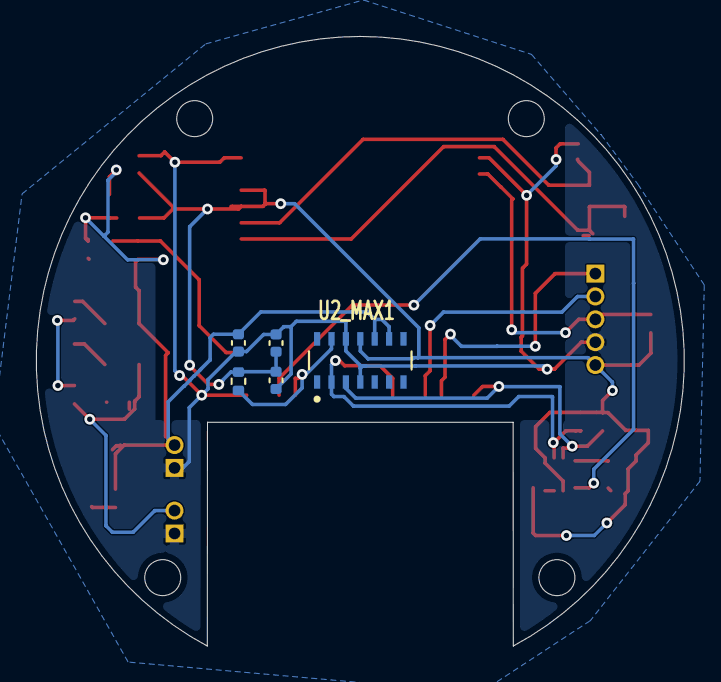
[picture p40: board watchwise_main.kicad_pcb from below]

Board: 2 copper layers, 36.0 x 33.9 mm, 34 parts (5 on the bottom side), 18 nets.

Parts:
BATT: J2 Battery; PinHeader_1x02_P1.27mm_Vertical
C1, C2, C4, C6, C10: 0.1uF; C_0402_1005Metric
C3: 4.7uF; C_0402_1005Metric
C5: 10uF; C_0805_2012Metric
C7, C8: 6pF; C_0402_1005Metric
C9: 10uF; C_0603_1608Metric
C11, C12: 1uF; C_0402_1005Metric
C13, C14: 4.7uF; C_0603_1608Metric
CHAR: J3 Charging; PinHeader_1x02_P1.27mm_Vertical
JPROG1: Prog; PinHeader_1x05_P1.27mm_Vertical
P_BATT1: LED; LED_0402_1005Metric
P_CHAR1: LED; LED_0402_1005Metric
R1, R2, R3: 4.7k; R_0402_1005Metric
R4: 10k; R_0402_1005Metric
RD1: 100k; R_0402_1005Metric
RD2: 220k; R_0402_1005Metric
RLED1: 0.47k; R_0402_1005Metric
RTC1: 32.768KHZ; Crystal_SMD_3215-2Pin_3.2x1.5mm
R_PROG1: 47k; R_0402_1005Metric
R_PWR1: 10k; R_0402_1005Metric
U1_IMU1: BMI270; XDCR_BMI270
U2_MAX1: MAX30102EFD_T; XDCR_MAX30101EFD_
U3_CYBLE1: CYBLE-416045-02
U4_CHAR1: MCP73831-2-OT; SOT-23-5
U5_1P8: TLV70018_SOT353; SOT-353_SC-70-5

Connections:
+1V8: C1.1, C2.1, C3.1, C4.1, C9.1, C10.1, C12.2, JPROG1.5, R1.1, R2.1, R3.1, R4.1, U1_IMU1.5 (VDDIO), U1_IMU1.8 (VDD), U1_IMU1.12 (CSB), U2_MAX1.11 (VDD), U3_CYBLE1.3 (VBACKUP), U3_CYBLE1.4 (VDD), U5_1P8.5 (OUT)
/RTC: C7.1, RTC1.1, U3_CYBLE1.5 (P0_0)
/RTC_N: C8.1, RTC1.2, U3_CYBLE1.6 (P0_1)
BAT_OUT: BATT.2, C5.1, C6.2, C11.2, C14.2, RD2.2, R_PWR1.1, U2_MAX1.9 (VLED+), U2_MAX1.10 (VLED+), U4_CHAR1.3 (V_{BAT}), U5_1P8.1 (IN), U5_1P8.3 (EN)
GND: BATT.1, C1.2, C2.2, C3.2, C4.2, C5.2, C6.1, C7.2, C8.2, C9.2, C10.2, C11.1, C12.1, C13.2, C14.1, CHAR.1, JPROG1.4, P_BATT1.1 (K), RD1.2, R_PROG1.2, U1_IMU1.1 (SDO), U1_IMU1.6 (GNDIO), U1_IMU1.7 (GND), U2_MAX1.4 (PGND), U2_MAX1.12 (GND), U3_CYBLE1.1 (GND), U3_CYBLE1.15 (GND), U3_CYBLE1.43 (GND), U4_CHAR1.2 (V_{SS}), U5_1P8.2 (GND)
INT_IMU: U1_IMU1.4 (INT1), U3_CYBLE1.17 (P9_0)
INT_MAX_N: R3.2, U2_MAX1.13 (~INT), U3_CYBLE1.18 (P9_1)
unnamed: C13.1, CHAR.2, RLED1.1, U4_CHAR1.4 (V_{DD})
unnamed: P_BATT1.2 (A), R_PWR1.2
unnamed: P_CHAR1.2 (A), RLED1.2
unnamed: P_CHAR1.1 (K), U4_CHAR1.1 (STAT)
unnamed: RD1.1, RD2.1, U3_CYBLE1.13 (P10_0)
unnamed: R_PROG1.1, U4_CHAR1.5 (PROG)
SCL: R2.2, U1_IMU1.13 (SCX), U2_MAX1.2 (SCL), U3_CYBLE1.24 (P6_4)
SDA: R1.2, U1_IMU1.14 (SDX), U2_MAX1.3 (SDA), U3_CYBLE1.29 (P6_5)
SWDCLK: JPROG1.2, U3_CYBLE1.26 (P6_7)
SWDIO: JPROG1.1, U3_CYBLE1.27 (P6_6)
XRES_N: JPROG1.3, R4.2, U3_CYBLE1.42 (~XRES)
