chancehowarth33/OpenBand/(commit log)

2026-04-29 Update README.md
    added voltage regulator components
2026-04-30 All sensors up and printing out serial
2026-04-30 update wuith main
    [01-Revision_History_and_Contents.SchDoc, 02-Components.SchDoc, 02-Components.kicad_sch, 03-MCU.SchDoc, 03-MCU.kicad_sch, 04-Programming_Reset.SchDoc, 04-Programming_Reset.kicad_sch, APA102C.STEP]
2026-04-30 fixed power sheet
    [01-Revision_History_and_Contents.SchDoc, 02-Components.SchDoc, 02-Components.kicad_sch, 03-MCU.SchDoc, 03-MCU.kicad_sch, 04-Programming_Reset.SchDoc, 04-Programming_Reset.kicad_sch, 05-power.kicad_sch]
2026-05-01 schematic changes
    [02-Components.kicad_sch, 03-MCU.kicad_sch, 04-Programming_Reset.kicad_sch, 05-power.kicad_sch]
2026-05-01 fixed errors with PCB
    [02-Components.kicad_sch, 03-MCU.kicad_sch, 04-Programming_Reset.kicad_sch, 05-power.kicad_sch, watchwise_main.kicad_pcb]
2026-05-01 pcb layout and battery
    [02-Components.kicad_sch, 03-MCU.kicad_sch, 04-Programming_Reset.kicad_sch, 05-power.kicad_sch, watchwise_main.kicad_pcb]
2026-05-01 removed USB-C, removed button, removed etra caps
    [03-MCU.kicad_sch, 04-Programming_Reset.kicad_sch, 05-power.kicad_sch, watchwise_main.kicad_pcb]
2026-05-01 fixed LIPO circuit footprint
    [02-Components.kicad_sch, 05-power.kicad_sch, watchwise_main.kicad_pcb]
2026-05-01 added PCB cutout
    [watchwise_main.kicad_pcb]
2026-05-02 breaking down SoC module
    [watchwise_main.kicad_pcb]
2026-05-03 Changed whole footprint to 16.5 mm radius
    [02-Components.kicad_sch, 03-MCU.kicad_sch, 05-power.kicad_sch, watchwise_main.kicad_pcb]
2026-05-03 thru holes smaller and cleaned up placement
    [watchwise_main.kicad_pcb]
2026-05-03 Back to 18mm diameter, new battery ordered with dimenstions 4 x 12 x 15mm (T*W*L)
    [05-power.kicad_sch, watchwise_main.kicad_pcb]
2026-05-03 flxed R_Prog value to be in the charging spec for battery
    [03-MCU.kicad_sch, 05-power.kicad_sch, WatchWise-BOM.csv, watchwise_main.kicad_pcb]
2026-05-04 Fixed cutout
    [02-Components.kicad_sch, 05-power.kicad_sch, WatchWise-BOM.csv, watchwise_main.kicad_pcb]
2026-05-04 moved components around to reduce noise
    [watchwise_main.kicad_pcb]
2026-05-04 cleanup refdes
    [05-power.kicad_sch, watchwise_main.kicad_pcb]
2026-05-05 routed but its shit
    [02-Components.kicad_sch, 03-MCU.kicad_sch, 04-Programming_Reset.kicad_sch, 05-power.kicad_sch, watchwise_main.kicad_pcb]
2026-05-05 no errors, with GND plane included
    [05-power.kicad_sch, watchwise_main.kicad_pcb]
2026-05-05 NO ERRORS
    [watchwise_main.kicad_pcb]
2026-05-05 clean up, no DRC errors all done
    [watchwise_main.kicad_pcb]
2026-05-06 clean up
    [watchwise_main.kicad_pcb]
2026-05-06 Added V1 gerber files
    [watchwise_main-Board.gbr, watchwise_main-Bottom Layer.gbr, watchwise_main-Bottom Overlay.gbr, watchwise_main-Bottom Paste.gbr, watchwise_main-Bottom Solder.gbr, watchwise_main-Top Layer.gbr, watchwise_main-Top Overlay.gbr, watchwise_main-Top Paste.gbr]
2026-05-07 Gerber files and drill and BOM
    [uw-madison-parts.SchLib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]
2026-05-07 All files completed
    [watchwise_main-Board.gbr, watchwise_main-Bottom Layer.gbr, watchwise_main-Bottom Overlay.gbr, watchwise_main-Bottom Paste.gbr, watchwise_main-Bottom Solder.gbr, watchwise_main-NPTH.drl, watchwise_main-PTH.drl, watchwise_main-Top Layer.gbr]
2026-05-09 cut out 17mm for battery
    [04-Programming_Reset.kicad_sch, 05-power.kicad_sch, BOM-watchwise_main.csv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]
2026-05-13 routing all good no GND plane yet
    [02-Components.kicad_sch, 03-MCU.kicad_sch, 04-Programming_Reset.kicad_sch, 05-power.kicad_sch, BOM-watchwise_main.csv, watchwise_main.kicad_pcb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]
2026-05-13 added voltage divider, need to clean up routing
    [03-MCU.kicad_sch, 04-Programming_Reset.kicad_sch, watchwise_main.kicad_pcb]
2026-05-14 all routing done no errors, added voltage divider resistors
    [watchwise_main.kicad_pcb]
2026-05-14 fixing close traces
    [BOM-watchwise_main.csv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]
2026-05-14 all finished, error check passes
    [02-Components.kicad_sch, 03-MCU.kicad_sch, BOM-watchwise_main.csv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]
2026-05-14 changed some compnonets and added updated BOM with digikey links
    [02-Components.kicad_sch, 03-MCU.kicad_sch, 05-power.kicad_sch, BOM-watchwise_main.csv, WatchWise-BOM.csv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]
2026-05-14 reverted caps back due to derating info, all files generated
    [02-Components.kicad_sch, 05-power.kicad_sch, BOM-watchwise_main.csv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]
2026-05-14 final rev, ordered PCB
    [02-Components.kicad_sch, 03-MCU.kicad_sch, 04-Programming_Reset.kicad_sch, 05-power.kicad_sch, BOM-watchwise_main.csv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]
2026-05-14 added digikey order info
    [digikey_order.csv]
2026-05-14 fixed readME
    [WatchWise-BOM.csv]
2026-05-15 update readme and add 3D models for chips
    [01-Revision_History_and_Contents.SchDoc, 02-Components.SchDoc, 02-Components.kicad_sch, 03-MCU.SchDoc, 03-MCU.kicad_sch, 04-Programming_Reset.SchDoc, 04-Programming_Reset.kicad_sch, 05-power.kicad_sch]
2026-05-29 added BMI270 receipt
    [02-Components.kicad_sch, watchwise_main.kicad_pcb]
2026-06-04 added case
    [nrf52840_ckaa_config4.DRL, nrf52840_ckaa_config4.GBL, nrf52840_ckaa_config4.GBO, nrf52840_ckaa_config4.GBP, nrf52840_ckaa_config4.GBS, nrf52840_ckaa_config4.GM1, nrf52840_ckaa_config4.GTL, nrf52840_ckaa_config4.GTO]
2026-06-20 redesign of case
    [watchwise_case.3mf, watchwise_case.scad, watchwise_case.stl]
2026-06-22 finished case with strap holes
    [watchwise_case_strap.scad]
2026-06-23 working case that fits enitre board snug. No battery mount yet
    [watchwise_case.3mf, watchwise_case.scad, watchwise_case_strap.scad, watchwise_case_strap.stl]
2026-06-24 Fix BMI270 step counter: read count from feature page 0, add load retry
    Step counting had regressed in db98e6a, which changed the count read
    from feature page 0 (BMI270_STEP_CNT_OUT_STRT_ADDR=0x00) to register
    0x1E. For the standard config blob the live count is published on
    feature page 0, so reading 0x1E always returned 0 and steps never
    accumulated. Reverted the read to feature page 0.
    Also add a config-load retry loop (soft reset + retry, up to 5x): the
    8KB config blob load over I2C is flaky, and a single bad load (junk
    INTERNAL_STATUS, e.g. 0x4E) would otherwise kill the whole IMU task.
    Verified on a known-good board: step count climbs 0->28 on a real walk
    and boots reliably across re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
2026-06-29 added low power mode and interctive BOM
    [watchwise_case.scad, watchwise_case.stl, watchwise_case_V1.scad, watchwise_case_V2.scad, watchwise_case_V2.stl]
2026-06-29 added clickable link in readME of interactive BOM
2026-06-29 moved BOM to top level of repo
2026-06-29 Add per-device serial number (DIS) and rename device to WatchWise
    - task_ble.c: populate the Device Information Service "Serial Number String"
    characteristic at BLE startup from the PSoC6 factory-unique die ID
    (app_set_dis_serial), so each unit reports a distinct 12-hex-char serial the
    app can read. Guard-compiled on HDLC_DIS_SERIAL_NUMBER_STRING_VALUE.
    (Complements the unique BLE address also derived from the die ID.)
    - design.cybt: rename the advertised/GATT device name to "WatchWise" and add
    the DIS Serial Number String characteristic.
    GeneratedSource regenerates from design.cybt on build.
2026-07-06 clickable BOM
2026-07-06 correct BOM link
2026-08-09 cleanup
    Prepare the repo for public release as a personal engineering showcase.
    README:
    - Reframe the project as an open-source, strap-worn health tracker
    ("I built my own WHOOP") rather than a watch-caseback accessory
    - Add the app UI screenshot, logo header, and metrics overview
    - Correct the firmware section, which still described the ECE 453 base
    project's motor-control GPIO instead of the actual sensor/BLE stack
    - Correct the repository tree, which no longer matched the real layout
    - Add a candid status section covering the battery-life ceiling
    Licensing:
    - LICENSE: MIT, covering firmware and the iOS app
    - LICENSE-HARDWARE: CC BY 4.0, covering PCB, enclosure, and BOM
    - NOTICE: att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
    [main.c]
2026-08-09 rename project to OpenBand, drop logo
    [OpenBand-BOM.csv, openband_case.3mf, openband_case_V1.scad, openband_case_V2.scad, openband_case_V2.stl, openband_case_strap.stl]
2026-08-09 revert rename outside README, drop logo
    [WatchWise-BOM.csv, watchwise_case.3mf, watchwise_case_V1.scad, watchwise_case_V2.scad, watchwise_case_V2.stl, watchwise_case_strap.stl]
2026-08-10 document required btstack feature-mask patch, drop debug printfs
2026-11-05 Update README with device details and corrections
    Clarified the description of the device's functionality and design.
